AerorKus/FatChudRuns/README.md

# FatChudRuns
Threadmill for the crusty-ass white rat dog Tofu
