AerorKus/FatChudRuns/footprints/1825360_3/c-1825360-3-b-3d.stp

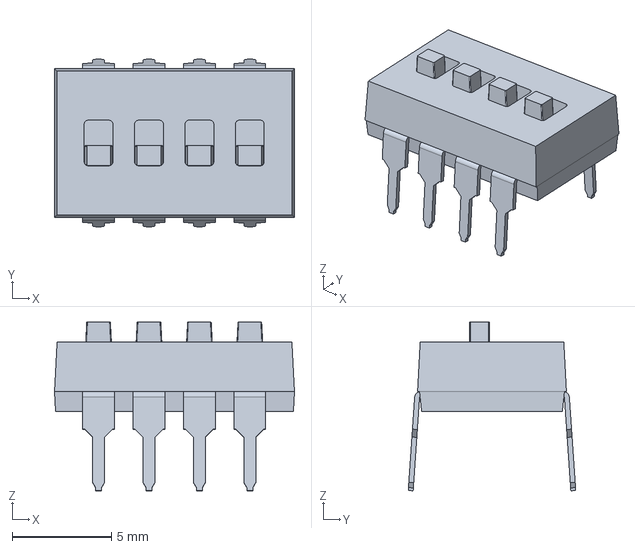
[picture p1: CAD file, 2026-03-14]
footprints/1825360_3/c-1825360-3-b-3d.stp
12.1 x 8.44 x 8.50 mm
