AerorKus/FatChudRuns/footprints/FTSH_107_01_L_DV_K_P/KiCADv6/CON14_2X7_DUK_FTSH_SAI.step

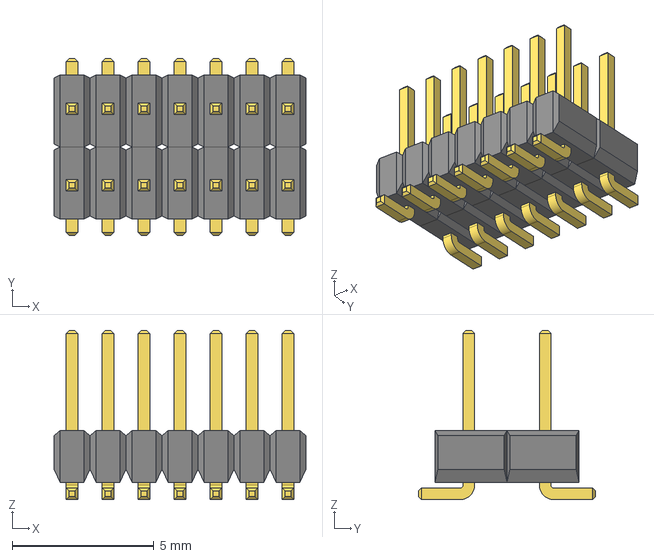
[picture p2: CAD file, 2026-03-02]
footprints/FTSH_107_01_L_DV_K_P/KiCADv6/CON14_2X7_DUK_FTSH_SAI.step
8.89 x 6.25 x 5.97 mm
