AerorKus/FatChudRuns/footprints/JXD6-0001NL/JXD6-0001NL.step

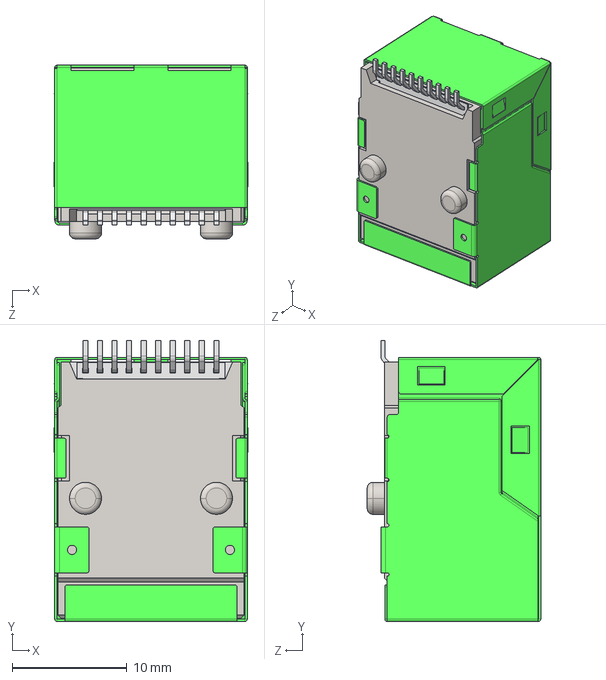
[picture p3: CAD file, 2026-04-10]
footprints/JXD6-0001NL/JXD6-0001NL.step
16.9 x 24.5 x 15.2 mm
