AerorKus/FatChudRuns/footprints/ST730M33R/SOT_30M33R_STM.step

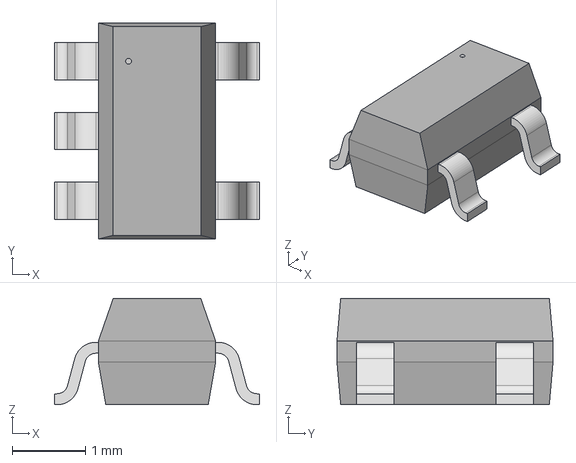
[picture p4: CAD file, 2026-03-04]
footprints/ST730M33R/SOT_30M33R_STM.step
2.79 x 2.95 x 1.45 mm
