AerorKus/FatChudRuns/footprints/TST_110_01_L_D/tst-110-01-l-d.stp

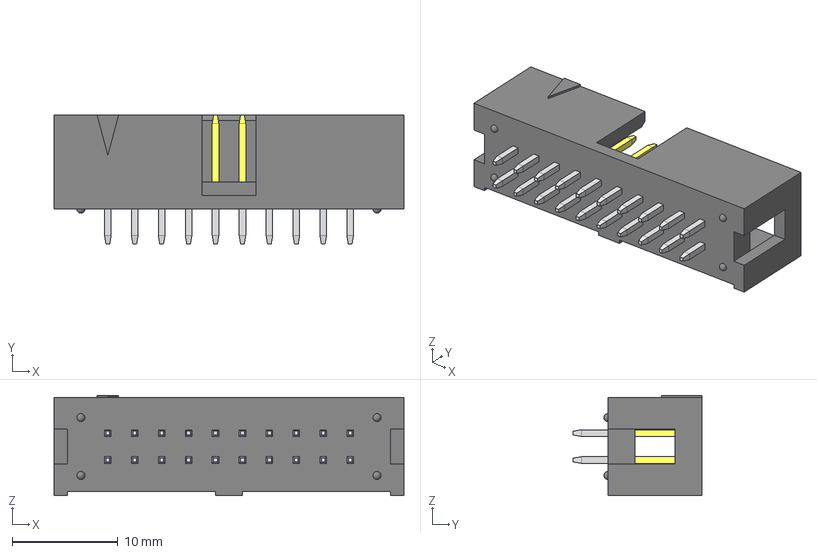
[picture p5: CAD file, 2026-03-01]
footprints/TST_110_01_L_D/tst-110-01-l-d.stp
33.0 x 12.2 x 9.47 mm
