AerorKus/FatChudRuns/ref/JXD6-0001NL.pdf

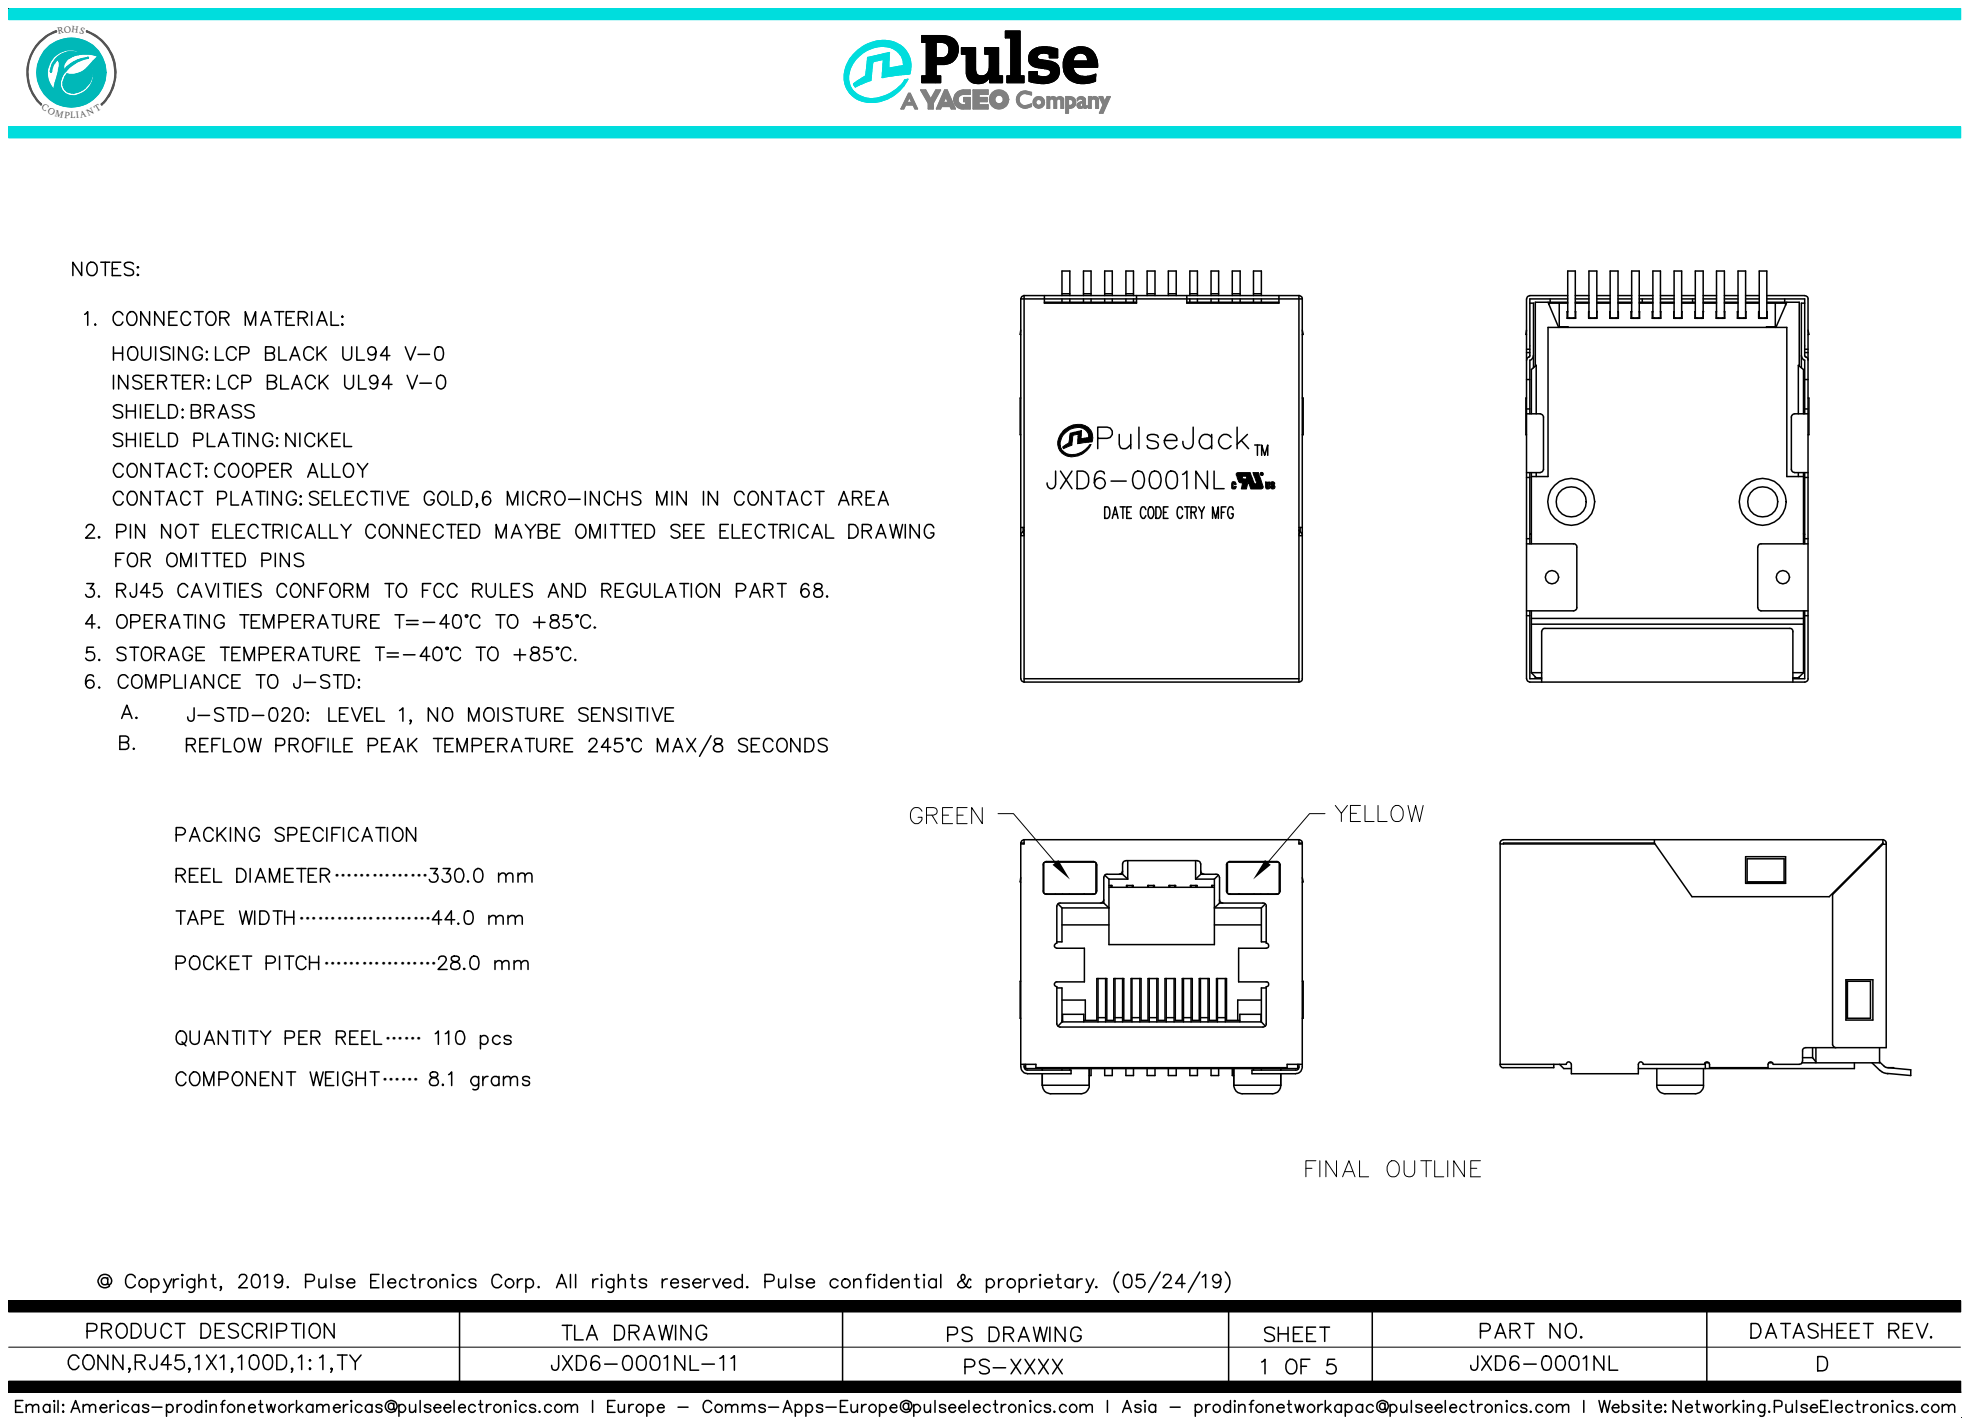
[picture p6: page 1]
ROHS; COM PLIA N T

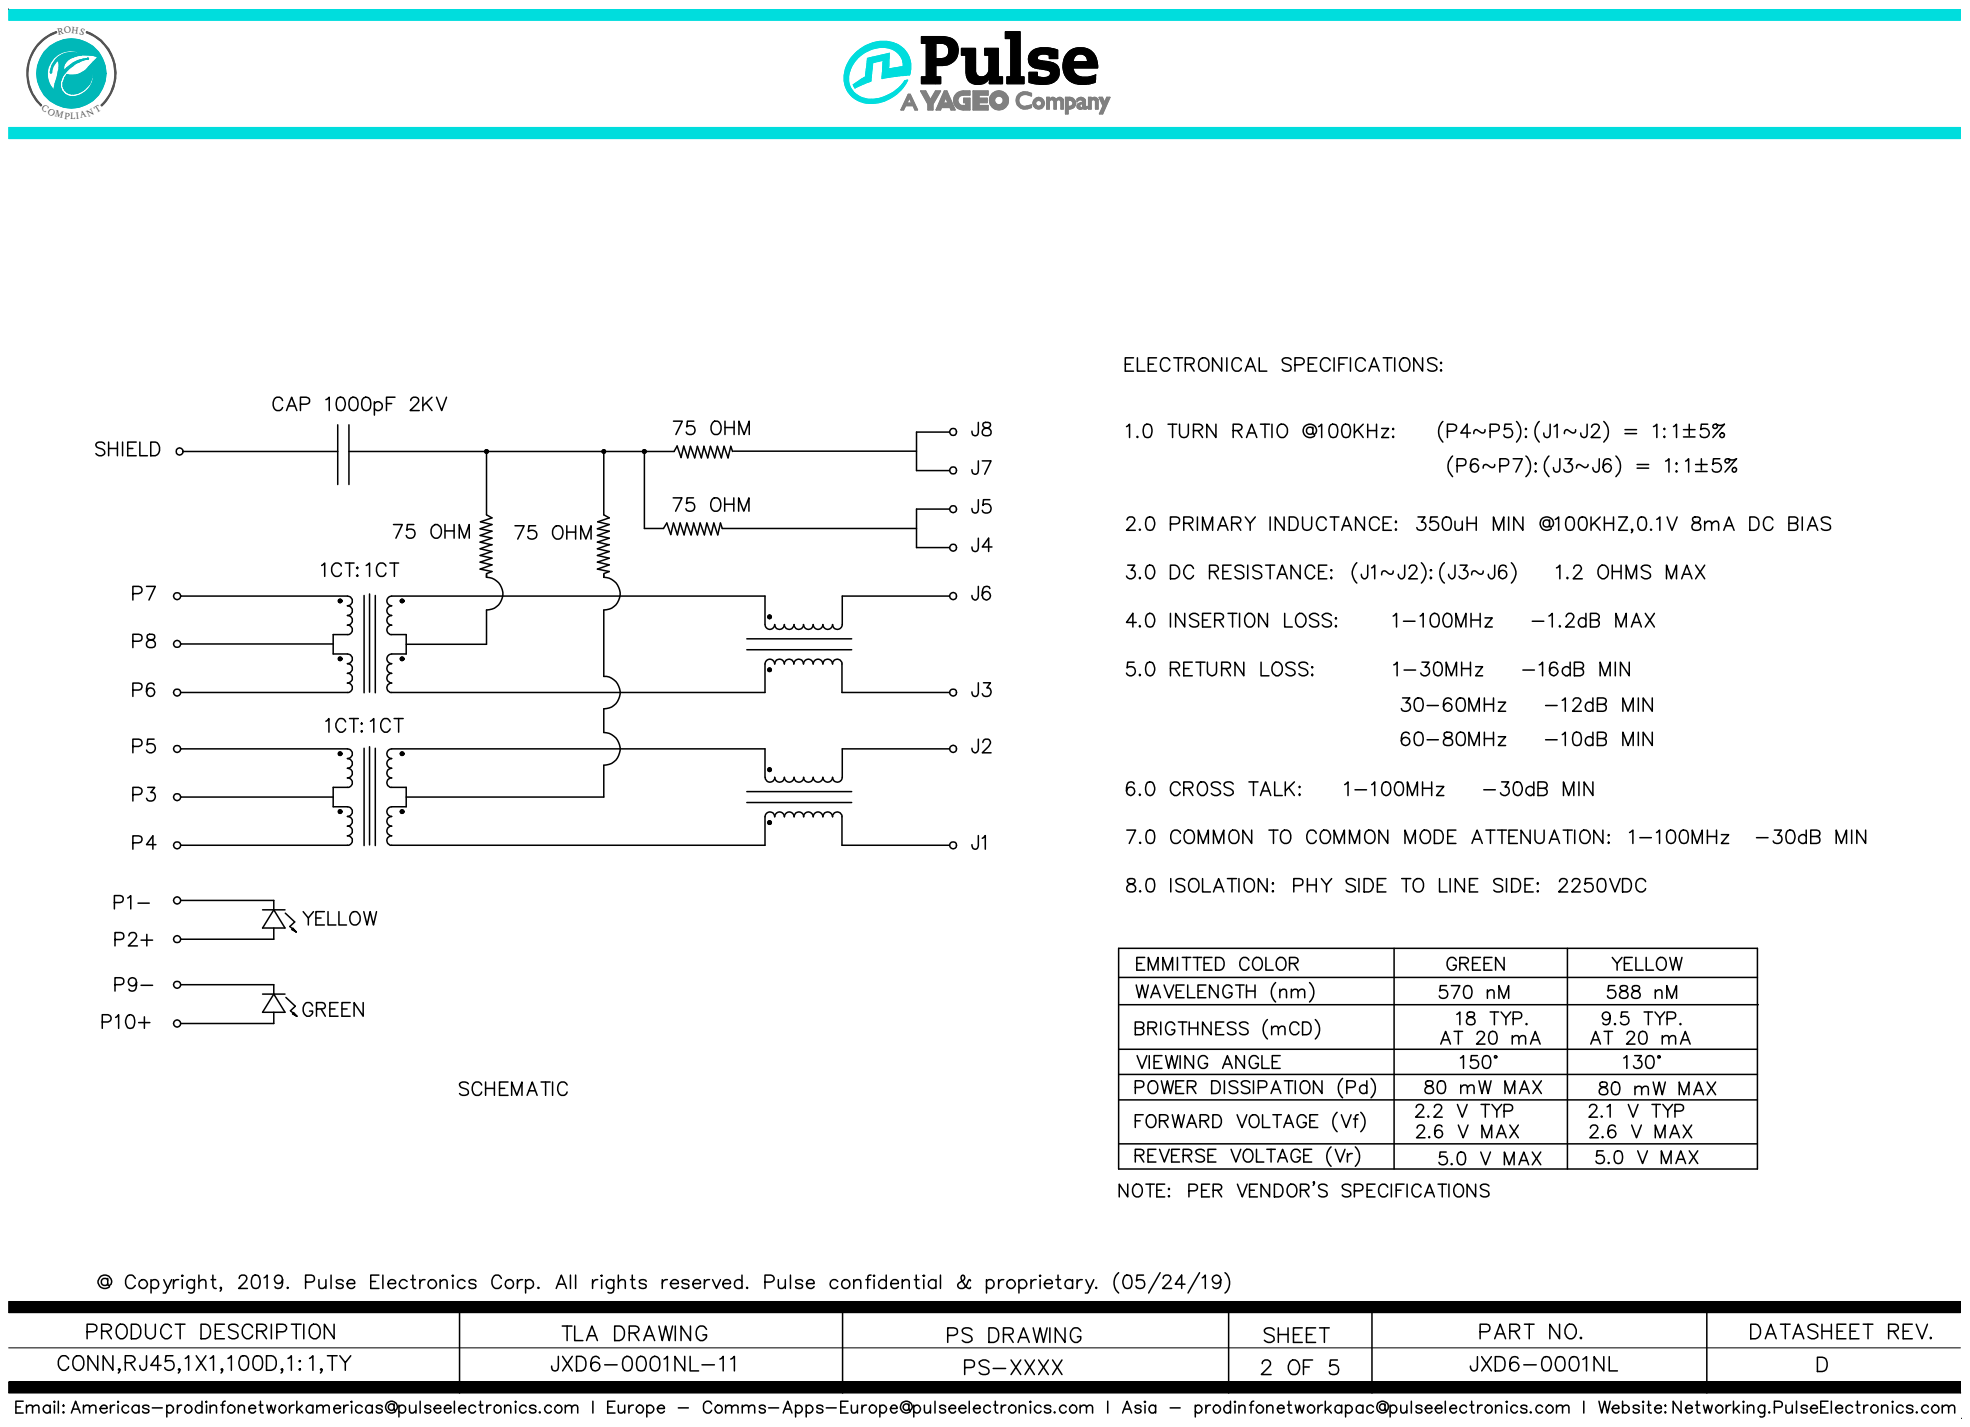
[picture p7: page 2]
COM PLIA N T

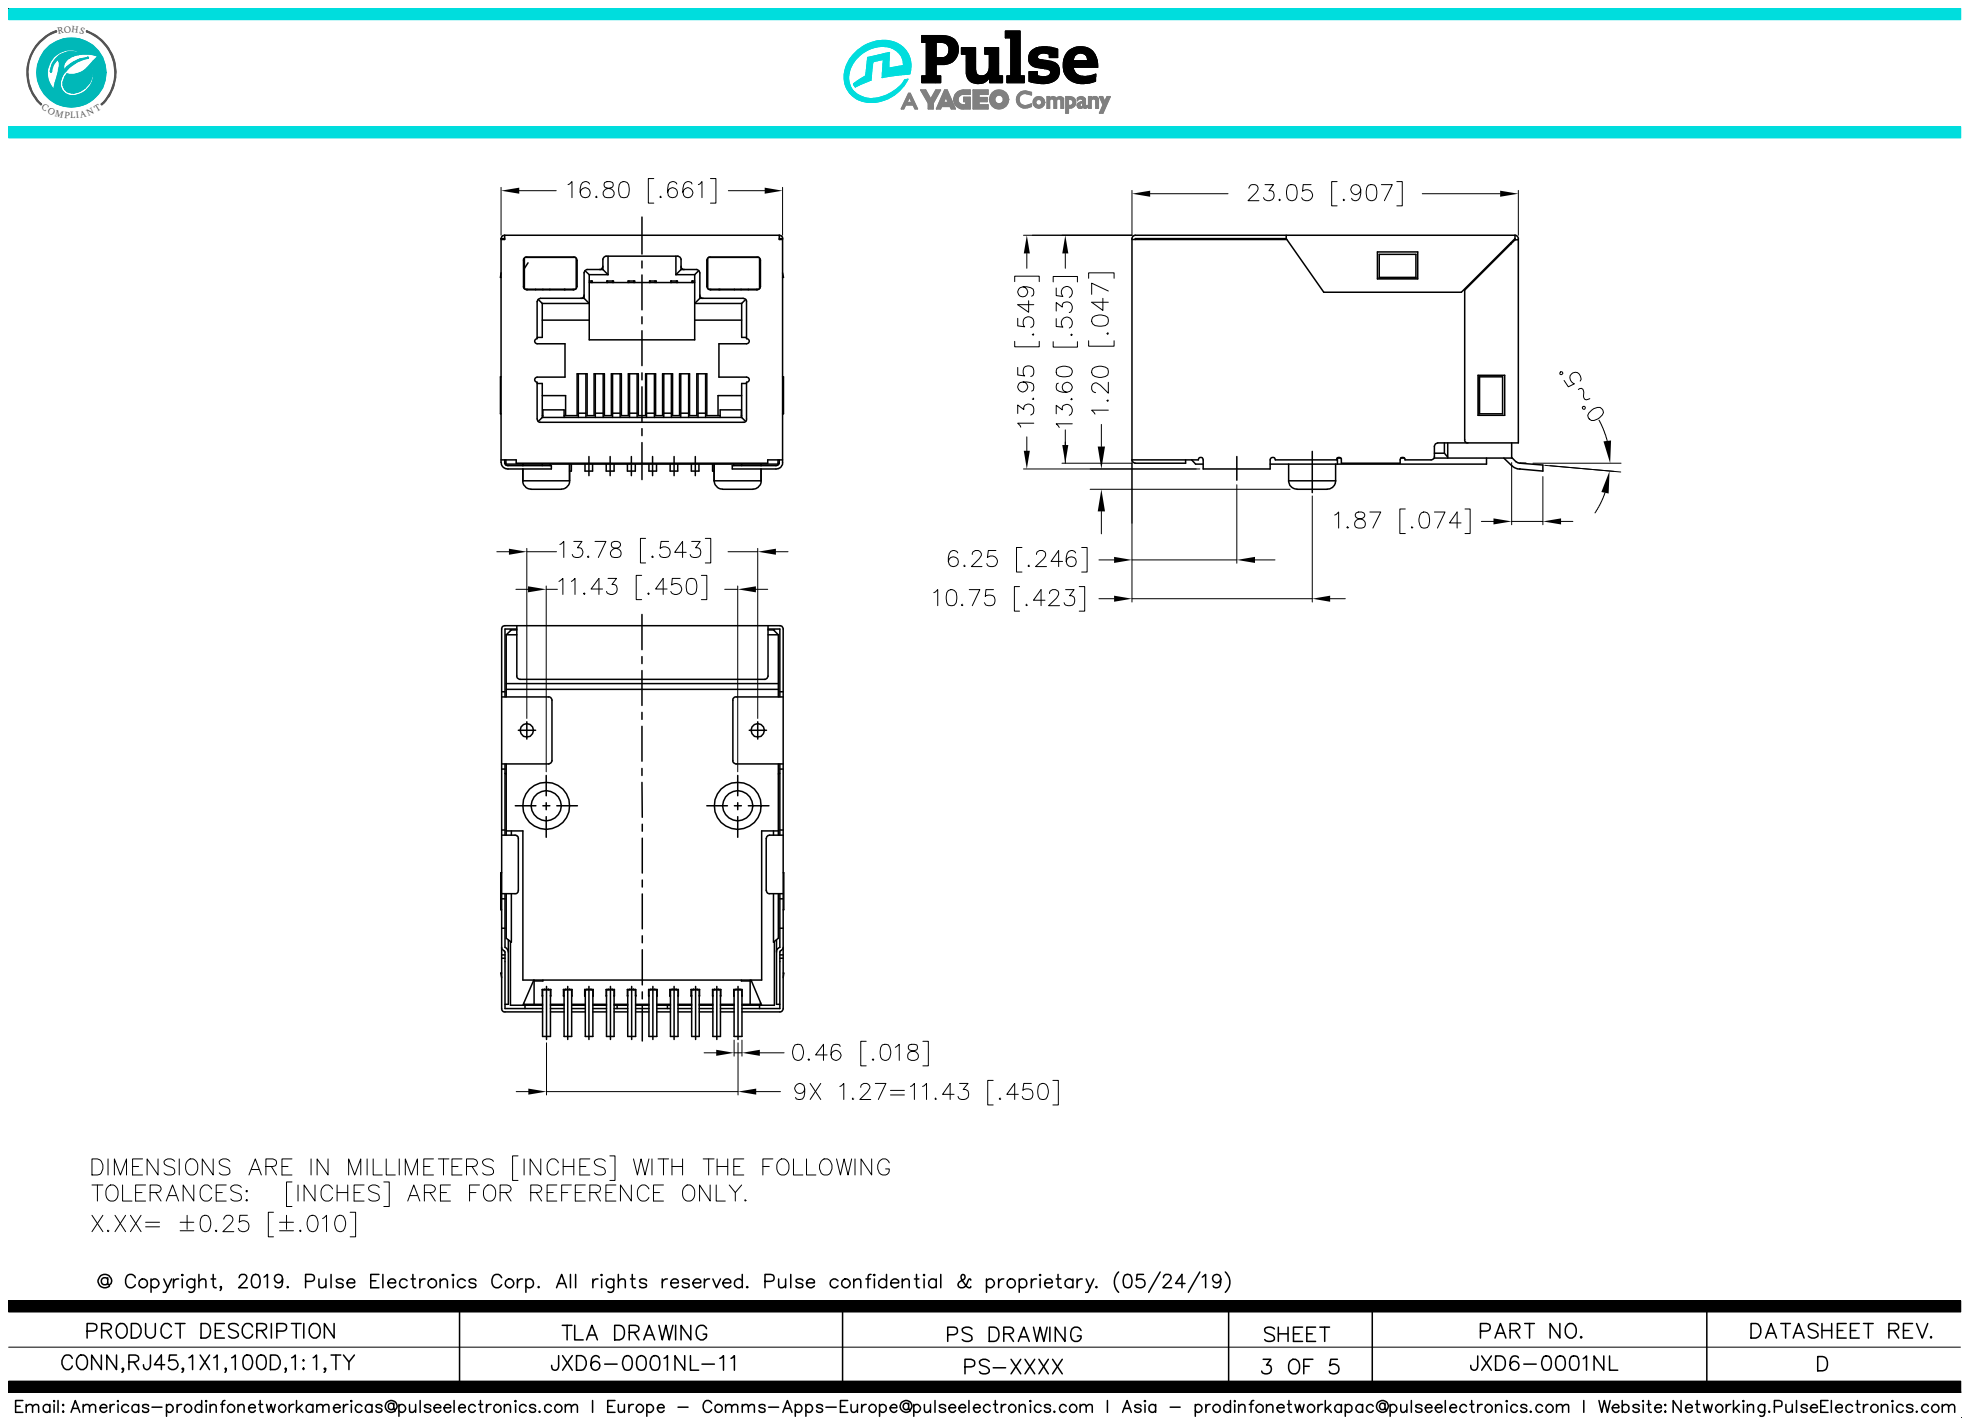
[picture p8: page 3]
COM PLIA N T

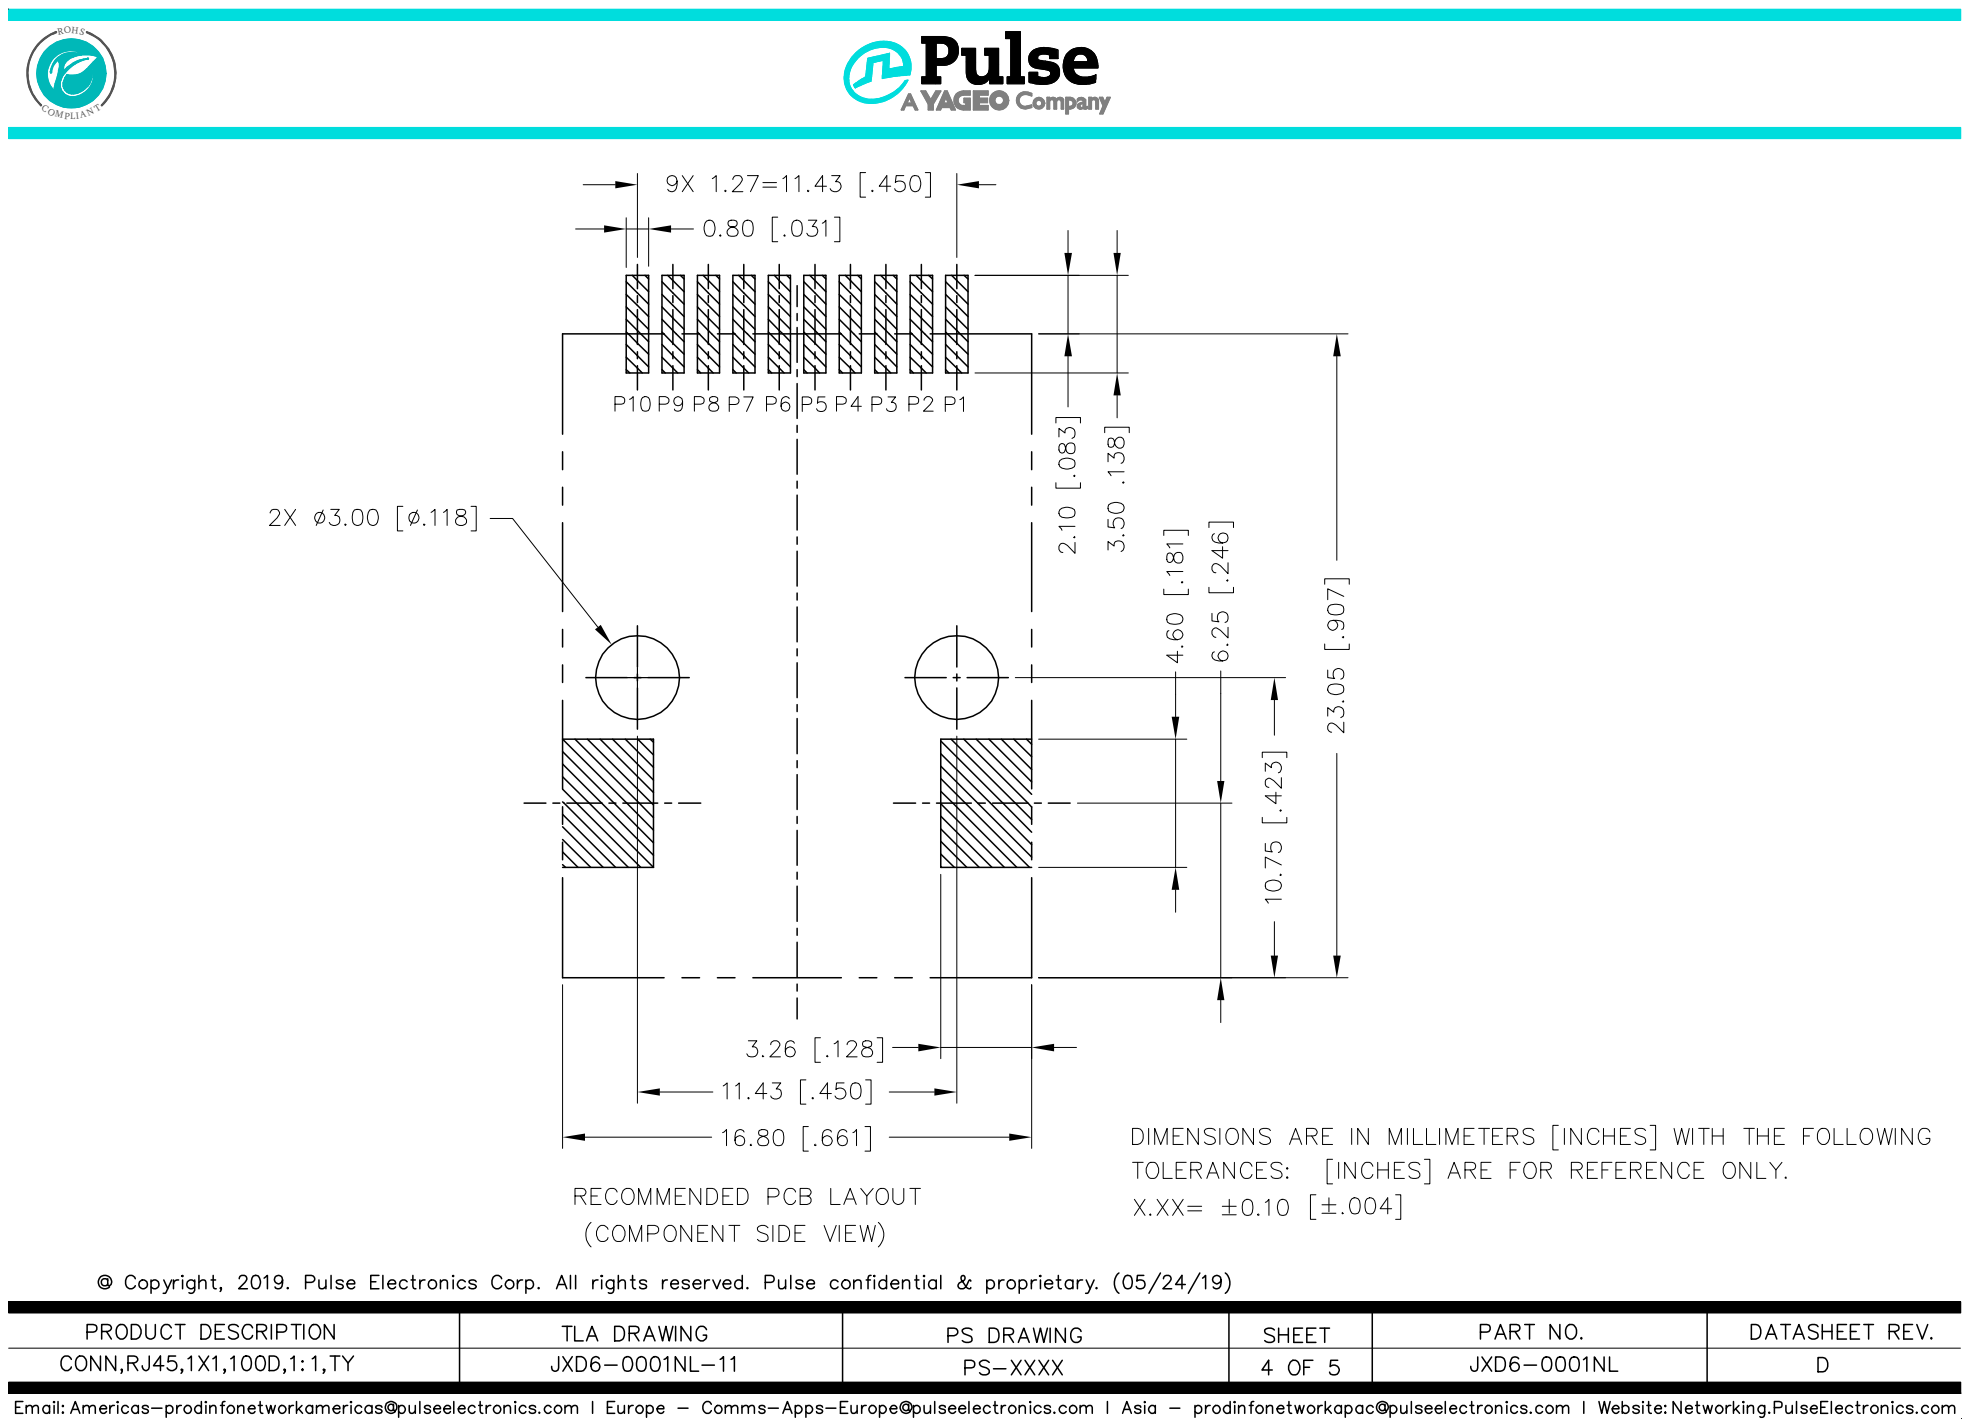
[picture p9: page 4]
COM PLIA N T

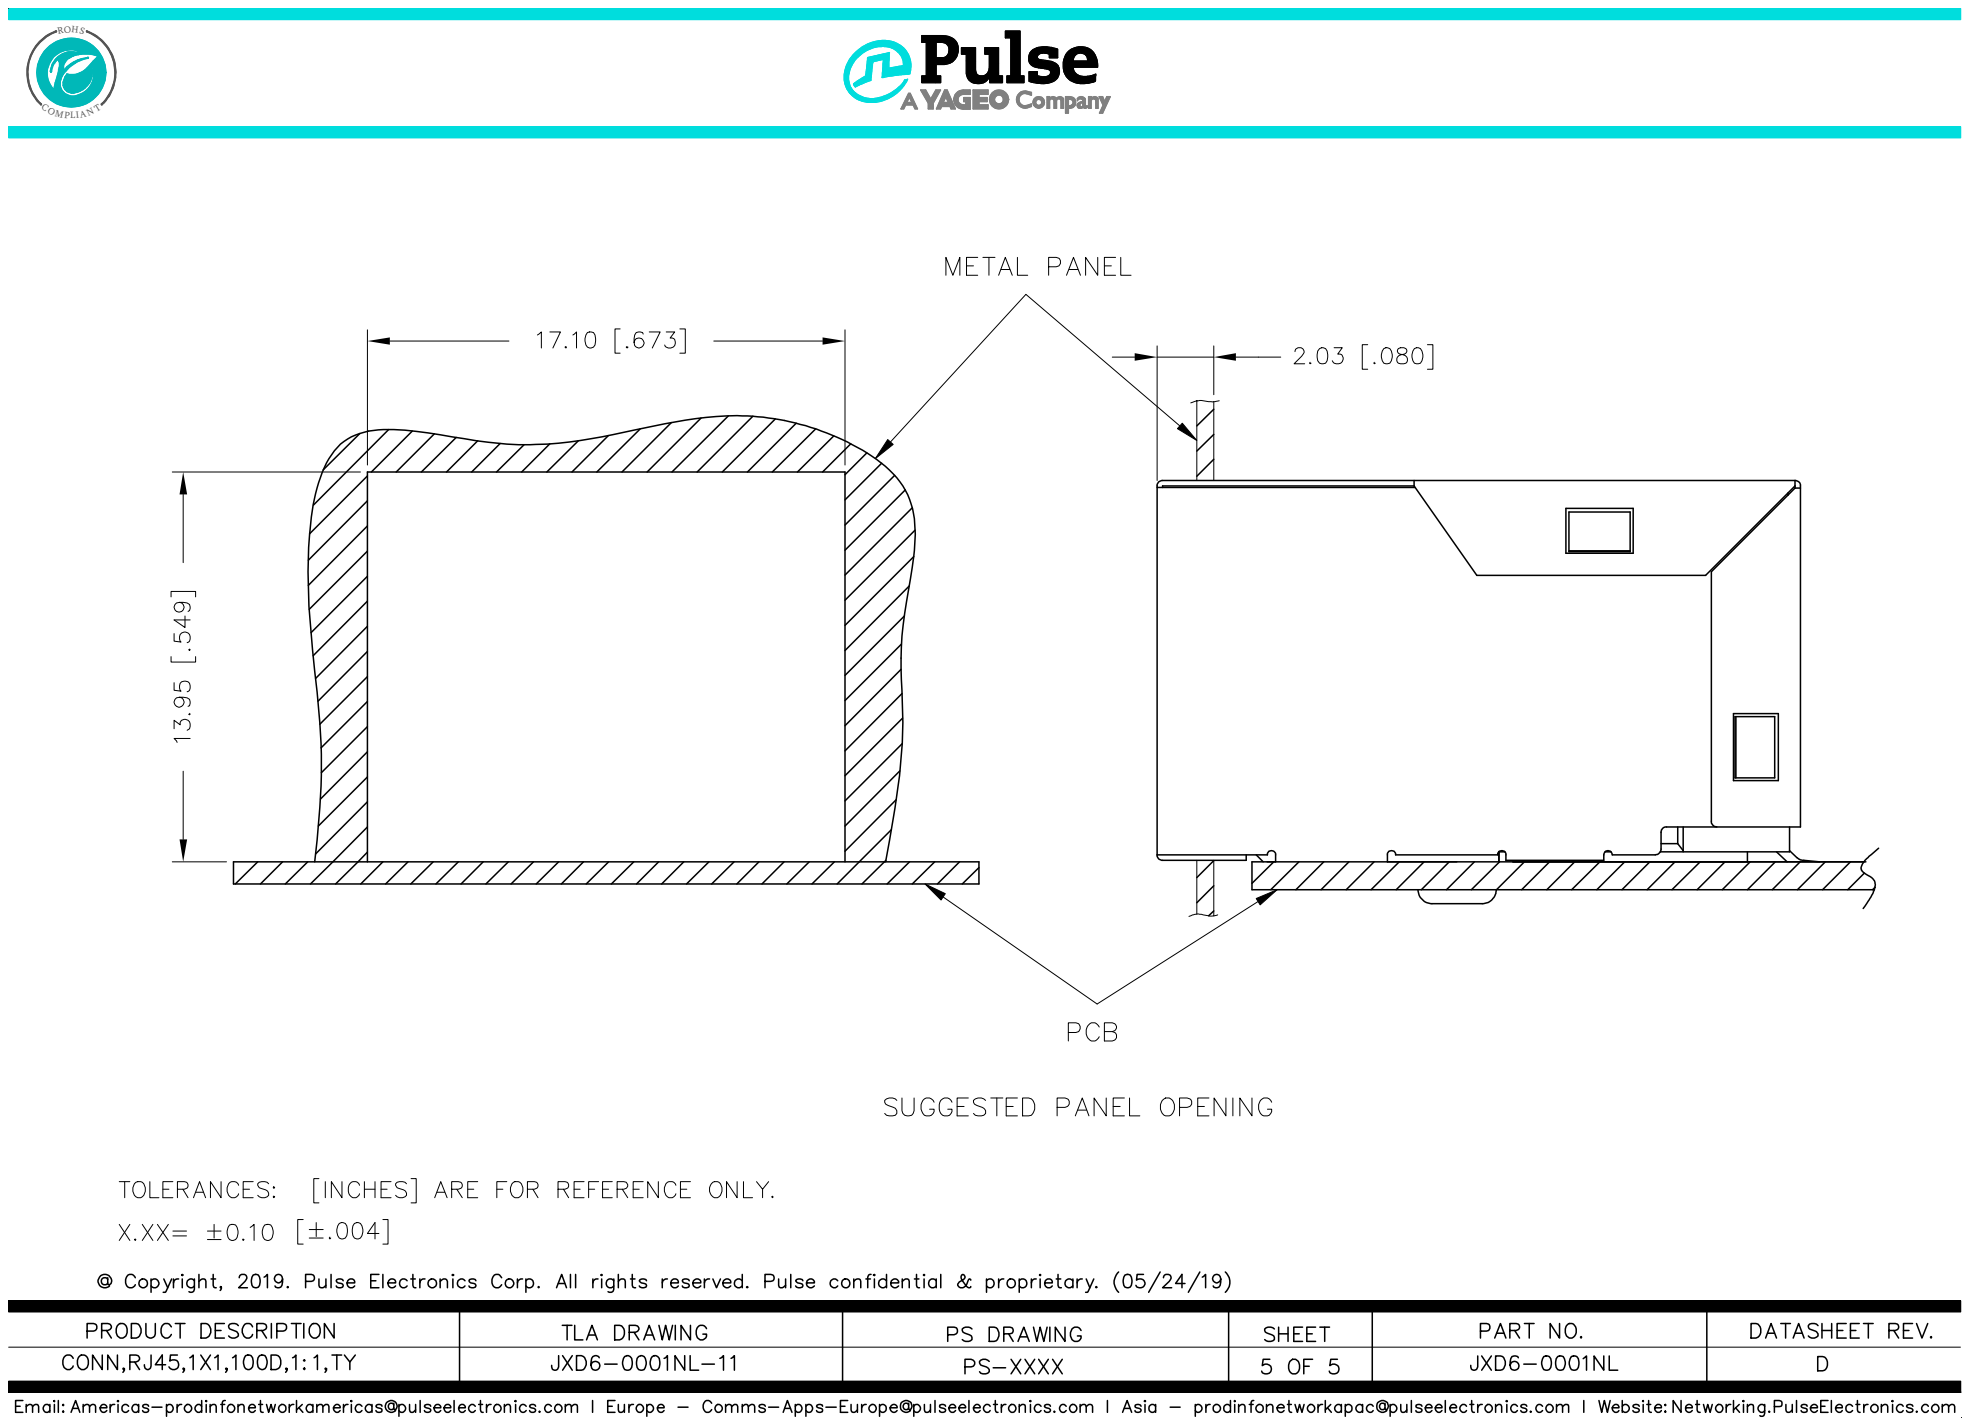
[picture p10: page 5]
COM PLIA N T
