AerorKus/FatChudRuns/FatChudRuns/FatChudRuns.kicad_pcb

## KiCad design FatChudRuns/FatChudRuns.kicad_pcb (2026-04-10)

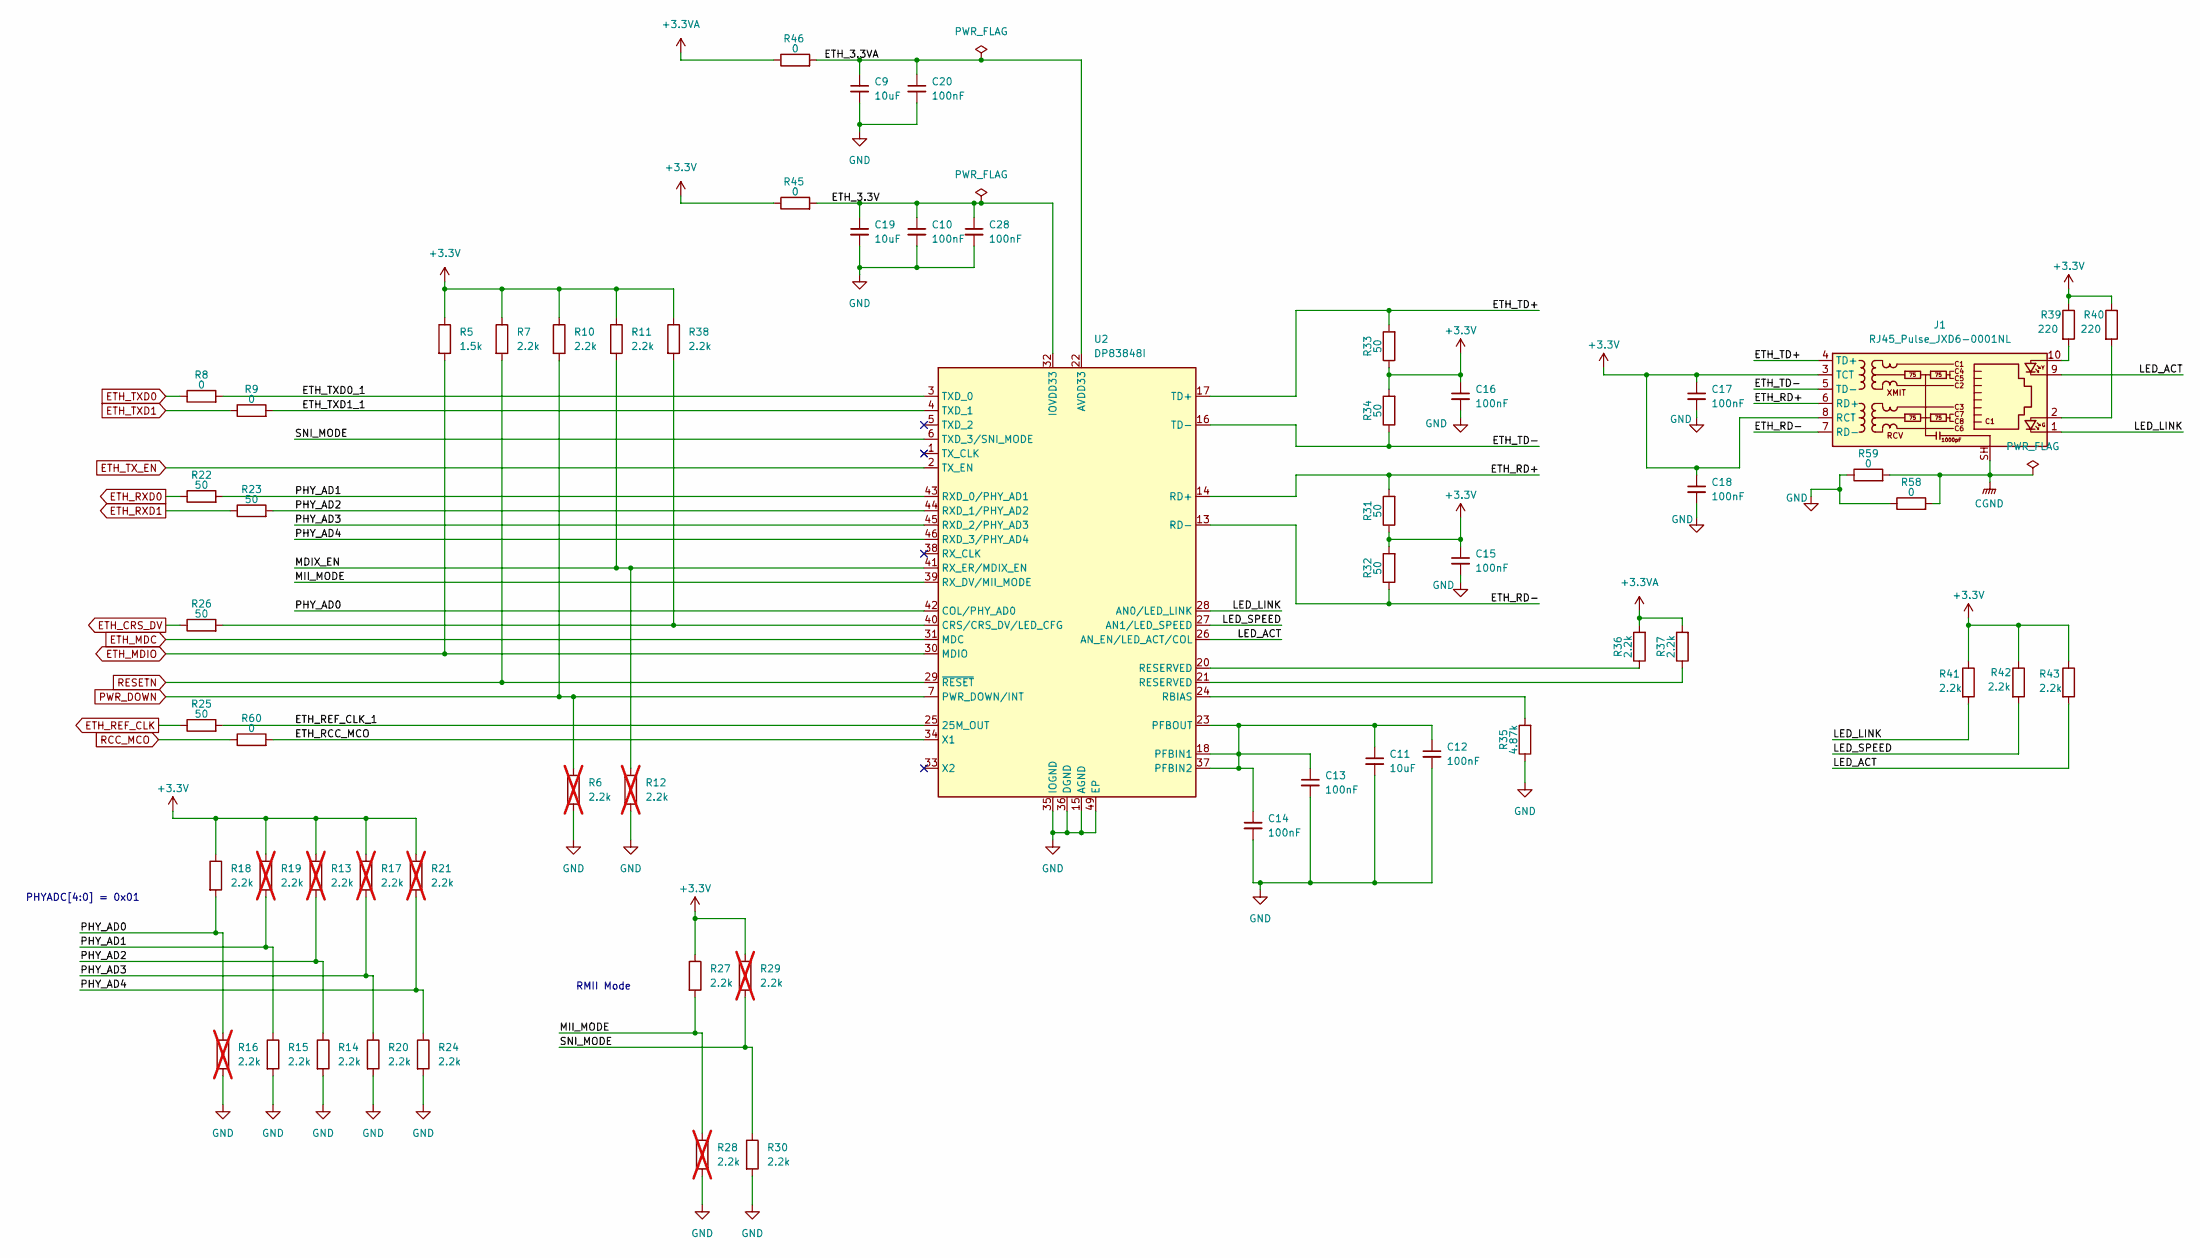
[picture p11: schematic ETH_PHY.kicad_sch]

Parts:
C9, C11, C19: 10uF; C_0805_2012Metric; JLCPCB Part # C2167271
C10, C12, C13, C14, C15, C16, C17, C18, C20, C28: 100nF; C_0603_1608Metric; JLCPCB Part # C2181816
J1: RJ45_Pulse_JXD6-0001NL; RJ45_Pulse_JXD6-0001NL_Horizontal; JLCPCB Part # C5359047
R5: 1.5k; R_0603_1608Metric; JLCPCB Part # C114668
R6, R12, R13, R16, R17, R19, R21, R28, R29: 2.2k; R_0603_1608Metric; not fitted
R7, R10, R11, R14, R15, R18, R20, R24, R27, R30, R36, R37, R38, R41, R42, R43: 2.2k; R_0603_1608Metric; JLCPCB Part # C113303
R8, R9, R45, R46, R58, R59, R60: 0; R_0603_1608Metric; JLCPCB Part # C95177
R22, R23, R25, R26, R31, R32, R33, R34: 50; R_0603_1608Metric; JLCPCB Part # C849792
R35: 4.87k; R_0603_1608Metric; JLCPCB Part # C137709
R39, R40: 220; R_0603_1608Metric; JLCPCB Part # C107696
U2: DP83848I; LQFP-48-1EP_7x7mm_P0.5mm_EP3.6x3.6mm_ThermalVias; JLCPCB Part # C12082

Connections:
+3.3V: C15.1, C16.1, C17.1, C18.1, J1.3 (TCT), J1.8 (RCT), R5.1, R7.1, R10.1, R11.1, R13.1, R17.1, R18.1, R19.1, R21.1, R27.1, R29.1, R31.1, R32.2, R33.1, R34.2, R38.1, R39.1, R40.1, R41.1, R42.1, R43.1, R45.1; also elsewhere on the board
+3.3VA: R36.2, R37.2, R46.1; also elsewhere on the board
/ETH_PHY/ETH_3.3V: C10.1, C19.1, C28.1, R45.2, U2.32 (IOVDD33), U2.48 (IOVDD33)
/ETH_PHY/ETH_3.3VA: C9.1, C20.1, R46.2, U2.22 (AVDD33)
/ETH_PHY/ETH_RCC_MCO: R60.2, U2.34 (X1)
/ETH_PHY/ETH_RD+: J1.6 (RD+), R31.2, U2.14 (RD+)
/ETH_PHY/ETH_RD-: J1.7 (RD-), R32.1, U2.13 (RD-)
/ETH_PHY/ETH_REF_CLK_1: R25.2, U2.25 (25M_OUT)
/ETH_PHY/ETH_TD+: J1.4 (TD+), R33.2, U2.17 (TD+)
/ETH_PHY/ETH_TD-: J1.5 (TD-), R34.1, U2.16 (TD-)
/ETH_PHY/ETH_TXD0_1: R8.2, U2.3 (TXD_0)
/ETH_PHY/ETH_TXD1_1: R9.2, U2.4 (TXD_1)
/ETH_PHY/LED_ACT: J1.9, R43.2, U2.26 (AN_EN/LED_ACT/COL)
/ETH_PHY/LED_LINK: J1.1, R41.2, U2.28 (AN0/LED_LINK)
/ETH_PHY/LED_SPEED: R42.2, U2.27 (AN1/LED_SPEED)
/ETH_PHY/MDIX_EN: R11.2, R12.1, U2.41 (RX_ER/MDIX_EN)
/ETH_PHY/MII_MODE: R27.2, R28.1, U2.39 (RX_DV/MII_MODE)
/ETH_PHY/PHY_AD0: R16.1, R18.2, U2.42 (COL/PHY_AD0)
/ETH_PHY/PHY_AD1: R15.1, R19.2, R22.2, U2.43 (RXD_0/PHY_AD1)
/ETH_PHY/PHY_AD2: R13.2, R14.1, R23.2, U2.44 (RXD_1/PHY_AD2)
/ETH_PHY/PHY_AD3: R17.2, R20.1, U2.45 (RXD_2/PHY_AD3)
/ETH_PHY/PHY_AD4: R21.2, R24.1, U2.46 (RXD_3/PHY_AD4)
/ETH_PHY/SNI_MODE: R29.2, R30.1, U2.6 (TXD_3/SNI_MODE)
CGND: J1.SH, R58.2, R59.2
ETH_CRS_DV: R26.1; also elsewhere on the board
ETH_MDC: U2.31 (MDC); also elsewhere on the board
ETH_MDIO: R5.2, U2.30 (MDIO); also elsewhere on the board
ETH_REF_CLK: R25.1; also elsewhere on the board
ETH_RXD0: R22.1; also elsewhere on the board
ETH_RXD1: R23.1; also elsewhere on the board
ETH_TXD0: R8.1; also elsewhere on the board
ETH_TXD1: R9.1; also elsewhere on the board
ETH_TX_EN: U2.2 (TX_EN); also elsewhere on the board
GND: C9.2, C10.2, C11.2, C12.2, C13.2, C14.2, C15.2, C16.2, C17.2, C18.2, C19.2, C20.2, C28.2, R6.2, R12.2, R14.2, R15.2, R16.2, R20.2, R24.2, R28.2, R30.2, R35.1, R58.1, R59.1, U2.15 (AGND), U2.19 (AGND), U2.35 (IOGND), U2.36 (DGND), U2.47 (IOGND), U2.49 (EP); also elsewhere on the board
unnamed: J1.2, R40.2
unnamed: J1.10, R39.2
unnamed: R36.1, U2.20 (RESERVED)
unnamed: R37.1, U2.21 (RESERVED)
unnamed: R26.2, R38.2, U2.40 (CRS/CRS_DV/LED_CFG)
unnamed: C11.1, C12.1, C13.1, C14.1, U2.18 (PFBIN1), U2.23 (PFBOUT), U2.37 (PFBIN2)
unnamed: R35.2, U2.24 (RBIAS)
PWR_DOWN: R6.1, R10.2, U2.7 (PWR_DOWN/INT)
RCC_MCO: R60.1; also elsewhere on the board
RESETN: R7.2, U2.29 (~RESET)

Notes on the sheet:
RMII Mode
PHYADC[4:0] = 0x01

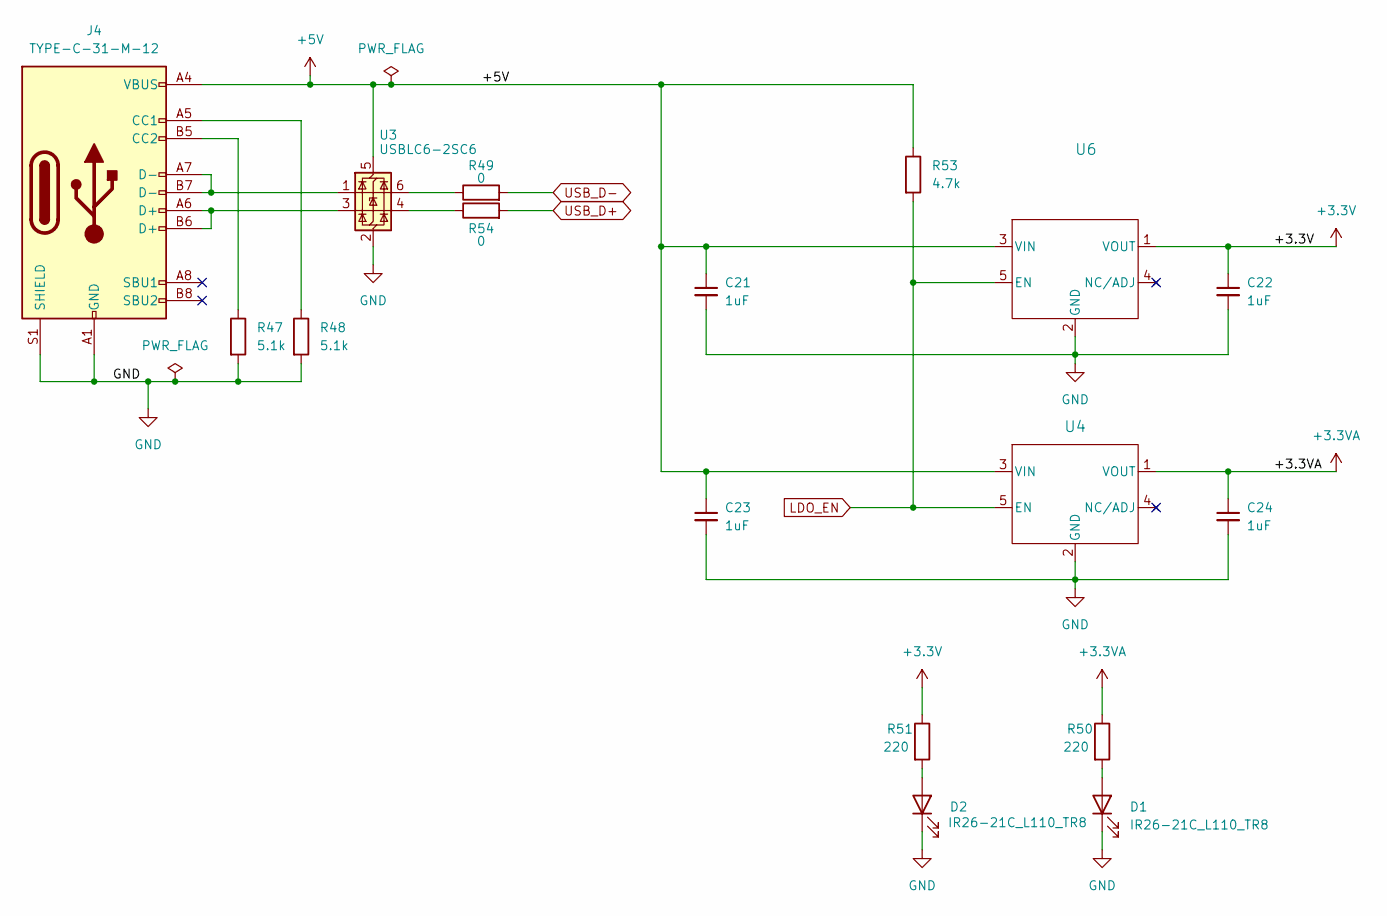
[picture p12: schematic POWER.kicad_sch]

Parts:
C21, C22, C23, C24: 1uF; C_0603_1608Metric; JLCPCB Part # C561804
D1, D2: IR26-21C_L110_TR8; LED_1206_3216Metric; JLCPCB Part # C73929
J4: TYPE-C-31-M-12; USB_C_Receptacle_GCT_USB4105-xx-A_16P_TopMnt_Horizontal; JLCPCB Part # C165948
R47, R48: 5.1k; R_0603_1608Metric; JLCPCB Part # C14677
R49, R54: 0; R_0603_1608Metric; JLCPCB Part # C95177
R50, R51: 220; R_0603_1608Metric; JLCPCB Part # C107696
R53: 4.7k; R_0603_1608Metric; JLCPCB Part # C99782
U3: USBLC6-2SC6; SOT-23-6; JLCPCB Part # C7519
U4, U6: ST730M33R; SOT_30M33R_STM; JLCPCB Part # C2846046

Connections:
+3.3V: C22.1, R51.1, U6.1 (VOUT); also elsewhere on the board
+3.3VA: C24.1, R50.1, U4.1 (VOUT); also elsewhere on the board
+5V: C21.1, C23.1, J4.A4 (VBUS), J4.A9 (VBUS), J4.B4 (VBUS), J4.B9 (VBUS), R53.1, U3.5 (VBUS), U4.3 (VIN), U6.3 (VIN)
GND: C21.2, C22.2, C23.2, C24.2, D1.1 (K), D2.1 (K), J4.A1 (GND), J4.A12 (GND), J4.B1 (GND), J4.B12 (GND), J4.S1 (SHIELD), R47.2, R48.2, U3.2 (GND), U4.2 (GND), U6.2 (GND); also elsewhere on the board
LDO_EN: R53.2, U4.5 (EN), U6.5 (EN); also elsewhere on the board
unnamed: D1.2 (A), R50.2
unnamed: D2.2 (A), R51.2
unnamed: J4.A5 (CC1), R48.1
unnamed: J4.B5 (CC2), R47.1
unnamed: J4.A6 (D+), J4.B6 (D+), U3.3 (I/O2)
unnamed: J4.A7 (D-), J4.B7 (D-), U3.1 (I/O1)
unnamed: R49.1, U3.6 (I/O1)
unnamed: R54.1, U3.4 (I/O2)
USB_D+: R54.2; also elsewhere on the board
USB_D-: R49.2; also elsewhere on the board

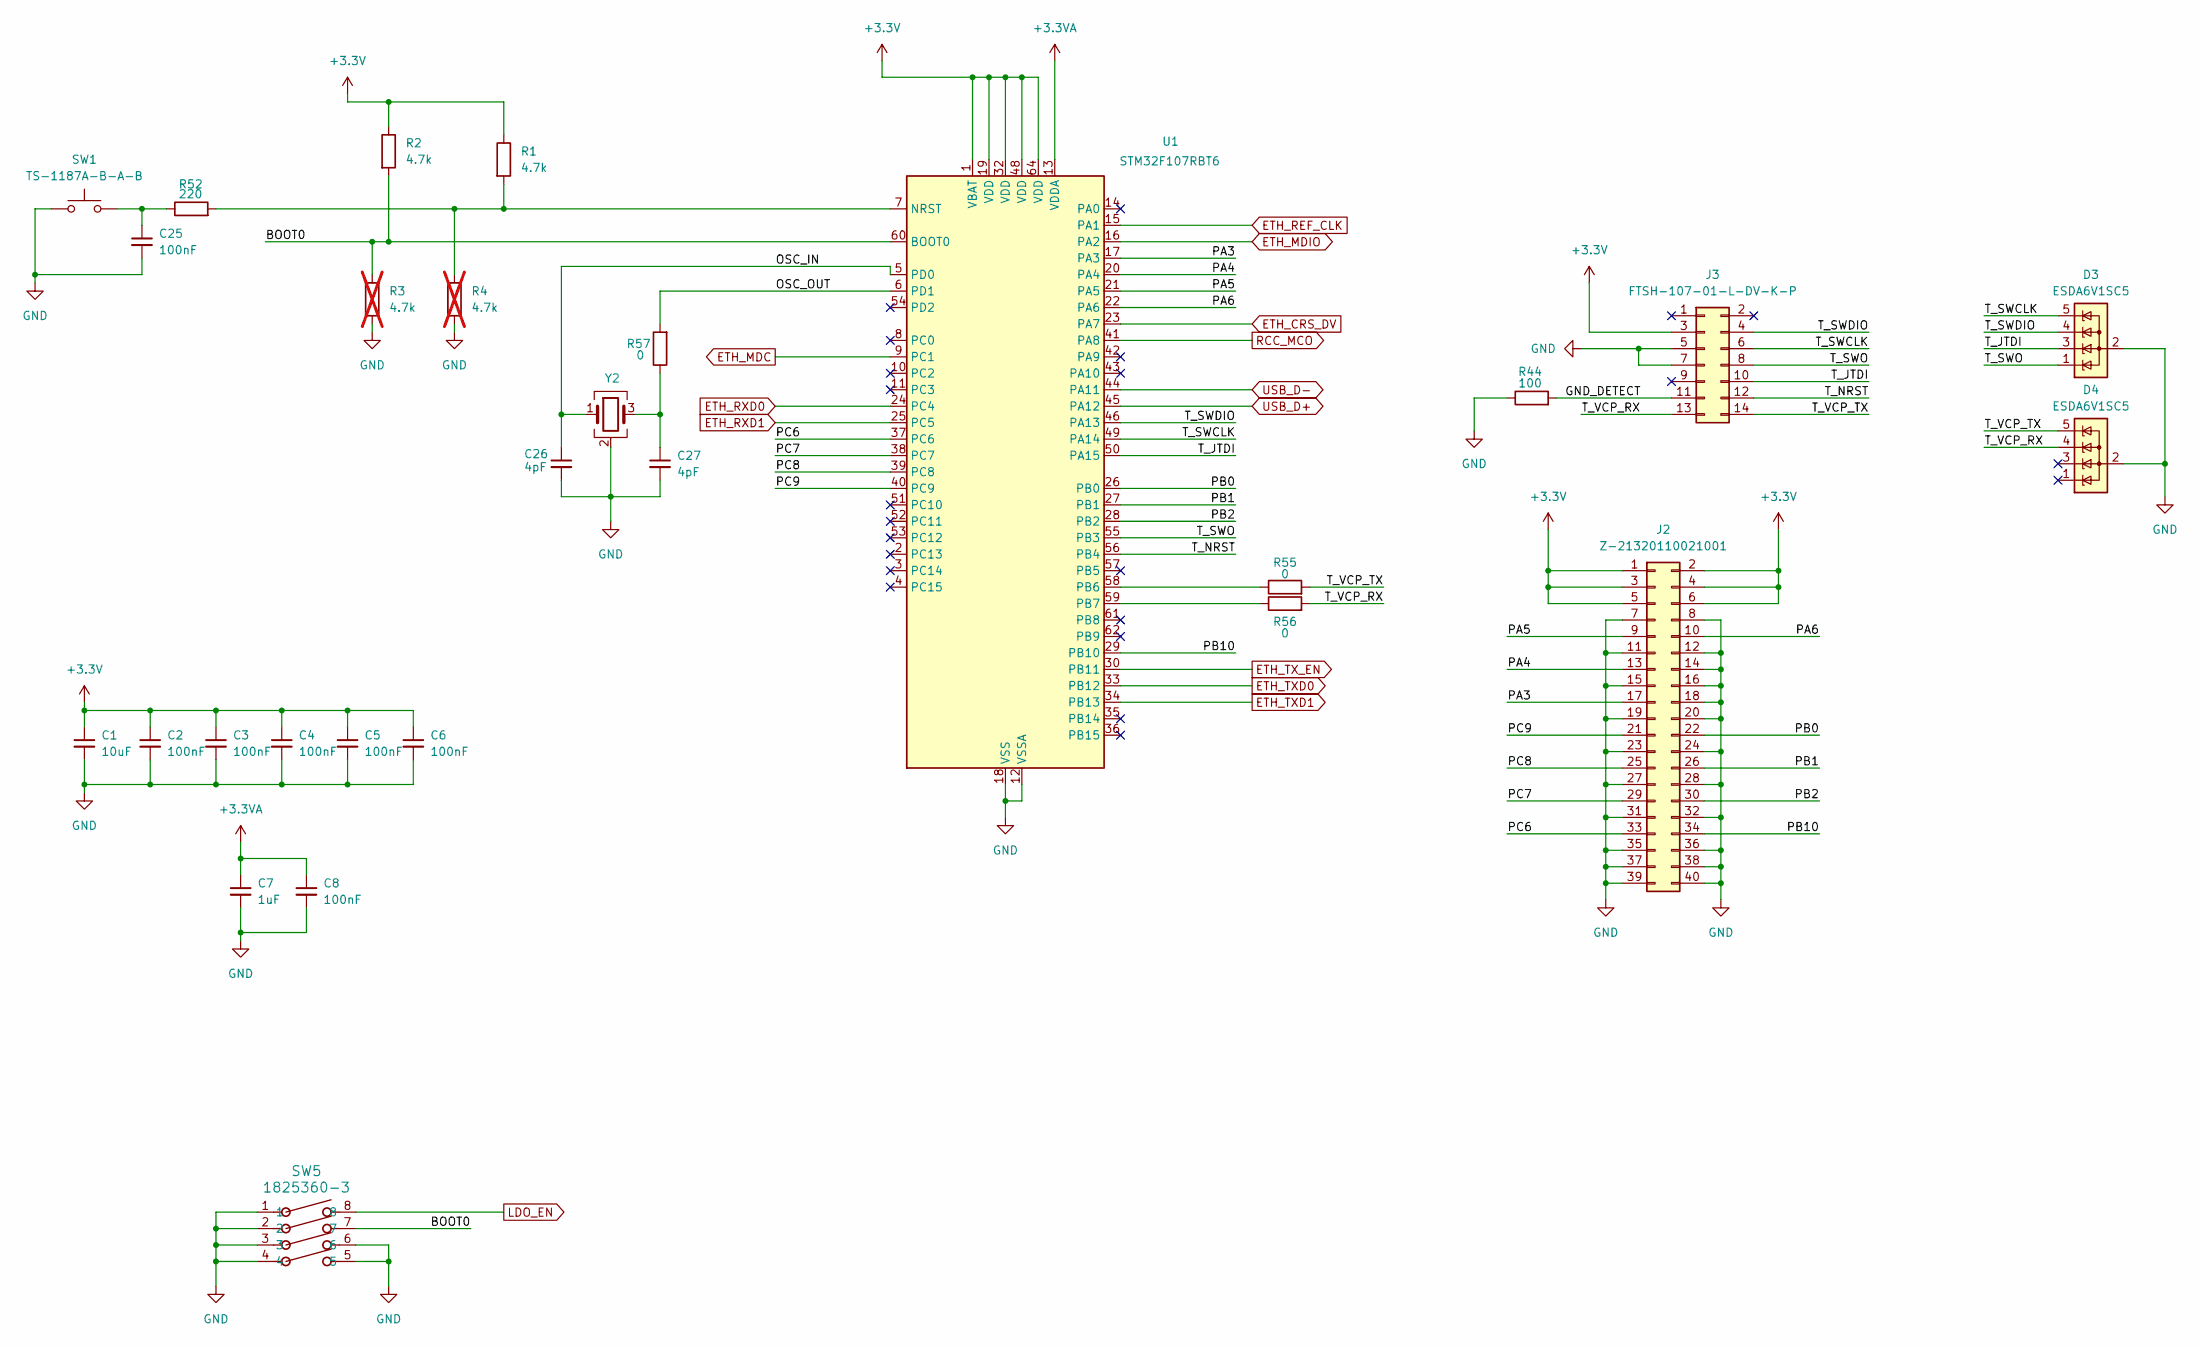
[picture p13: schematic MCU.kicad_sch]

Parts:
C1: 10uF; C_0805_2012Metric; JLCPCB Part # C2167271
C2, C3, C4, C5, C6, C8, C25: 100nF; C_0603_1608Metric; JLCPCB Part # C2181816
C7: 1uF; C_0603_1608Metric; JLCPCB Part # C561804
C26, C27: 4pF; C_0603_1608Metric; JLCPCB Part # C309461
D3, D4: ESDA6V1SC5; SOT-23-5; JLCPCB Part # C2935146
J2: Z-21320110021001; PinSocket_2x20_P2.54mm_Vertical; JLCPCB Part # C193453
J3: FTSH-107-01-L-DV-K-P; CON14_2X7_DUK_FTSH_SAI; JLCPCB Part # C5345538
R1, R2: 4.7k; R_0603_1608Metric; JLCPCB Part # C99782
R3, R4: 4.7k; R_0603_1608Metric; not fitted
R44: 100; R_0603_1608Metric; JLCPCB Part # C105588
R52: 220; R_0603_1608Metric; JLCPCB Part # C107696
R55, R56, R57: 0; R_0603_1608Metric; JLCPCB Part # C95177
SW1: TS-1187A-B-A-B; SW_SPST_TL3342; JLCPCB Part # C318884
SW5: 1825360-3; SWDIP8_300X185P100; JLCPCB Part # C574798
U1: STM32F107RBT6; LQFP-64_10x10mm_P0.5mm; JLCPCB Part # C16918
Y2: ABM8G-25.000MHZ-B4Y-T; Crystal_SMD_Abracon_ABM8AIG-4Pin_3.2x2.5mm; JLCPCB Part # C596913

Connections:
+3.3V: C1.1, C2.1, C3.1, C4.1, C5.1, C6.1, J2.1, J2.2, J2.3, J2.4, J2.5, J2.6, J3.3, R1.1, R2.1, U1.1 (VBAT), U1.19 (VDD), U1.32 (VDD), U1.48 (VDD), U1.64 (VDD); also elsewhere on the board
+3.3VA: C7.1, C8.1, U1.13 (VDDA); also elsewhere on the board
/MCU/BOOT0: R2.2, R3.1, SW5.7, U1.60 (BOOT0)
/MCU/GND_DETECT: J3.11, R44.2
/MCU/OSC_IN: C26.1, U1.5 (PD0), Y2.1
/MCU/OSC_OUT: R57.2, U1.6 (PD1)
/MCU/PA3: J2.17, U1.17 (PA3)
/MCU/PA4: J2.13, U1.20 (PA4)
/MCU/PA5: J2.9, U1.21 (PA5)
/MCU/PA6: J2.10, U1.22 (PA6)
/MCU/PB0: J2.22, U1.26 (PB0)
/MCU/PB1: J2.26, U1.27 (PB1)
/MCU/PB2: J2.30, U1.28 (PB2)
/MCU/PB10: J2.34, U1.29 (PB10)
/MCU/PC6: J2.33, U1.37 (PC6)
/MCU/PC7: J2.29, U1.38 (PC7)
/MCU/PC8: J2.25, U1.39 (PC8)
/MCU/PC9: J2.21, U1.40 (PC9)
/MCU/T_JTDI: D3.3 (K), J3.10, U1.50 (PA15)
/MCU/T_NRST: J3.12, U1.56 (PB4)
/MCU/T_SWCLK: D3.5 (K), J3.6, U1.49 (PA14)
/MCU/T_SWDIO: D3.4 (K), J3.4, U1.46 (PA13)
/MCU/T_SWO: D3.1 (K), J3.8, U1.55 (PB3)
/MCU/T_VCP_RX: D4.4 (K), J3.13, R56.2
/MCU/T_VCP_TX: D4.5 (K), J3.14, R55.2
ETH_CRS_DV: U1.23 (PA7); also elsewhere on the board
ETH_MDC: U1.9 (PC1); also elsewhere on the board
ETH_MDIO: U1.16 (PA2); also elsewhere on the board
ETH_REF_CLK: U1.15 (PA1); also elsewhere on the board
ETH_RXD0: U1.24 (PC4); also elsewhere on the board
ETH_RXD1: U1.25 (PC5); also elsewhere on the board
ETH_TXD0: U1.33 (PB12); also elsewhere on the board
ETH_TXD1: U1.34 (PB13); also elsewhere on the board
ETH_TX_EN: U1.30 (PB11); also elsewhere on the board
GND: C1.2, C2.2, C3.2, C4.2, C5.2, C6.2, C7.2, C8.2, C25.2, C26.2, C27.2, D3.2 (A), D4.2 (A), J2.7, J2.8, J2.11, J2.12, J2.14, J2.15, J2.16, J2.18, J2.19, J2.20, J2.23, J2.24, J2.27, J2.28, J2.31, J2.32, J2.35, J2.36, J2.37, J2.38, J2.39, J2.40, J3.5, J3.7, R3.2, R4.2, R44.1, SW1.1, SW5.1, SW5.2, SW5.3, SW5.4, SW5.5, SW5.6, U1.12 (VSSA), U1.18 (VSS), U1.31 (VSS), U1.47 (VSS), U1.63 (VSS), Y2.2 (G), Y2.4 (G); also elsewhere on the board
LDO_EN: SW5.8; also elsewhere on the board
unnamed: C25.1, R52.1, SW1.2
unnamed: C27.1, R57.1, Y2.3
unnamed: R1.2, R4.1, R52.2, U1.7 (NRST)
unnamed: R55.1, U1.58 (PB6)
unnamed: R56.1, U1.59 (PB7)
RCC_MCO: U1.41 (PA8); also elsewhere on the board
USB_D+: U1.45 (PA12); also elsewhere on the board
USB_D-: U1.44 (PA11); also elsewhere on the board

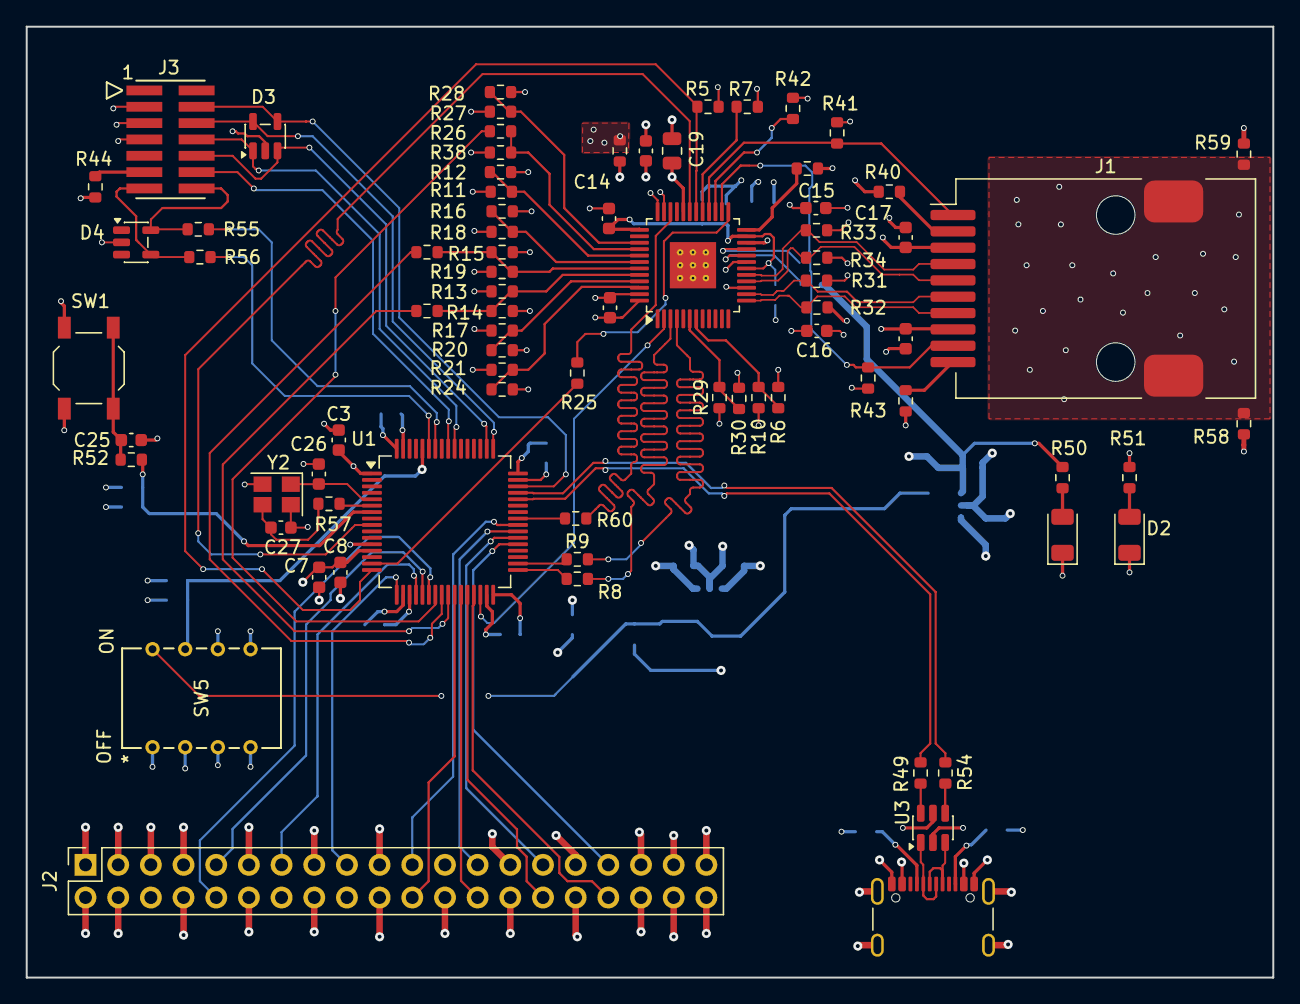
[picture p14: board FatChudRuns.kicad_pcb from above]

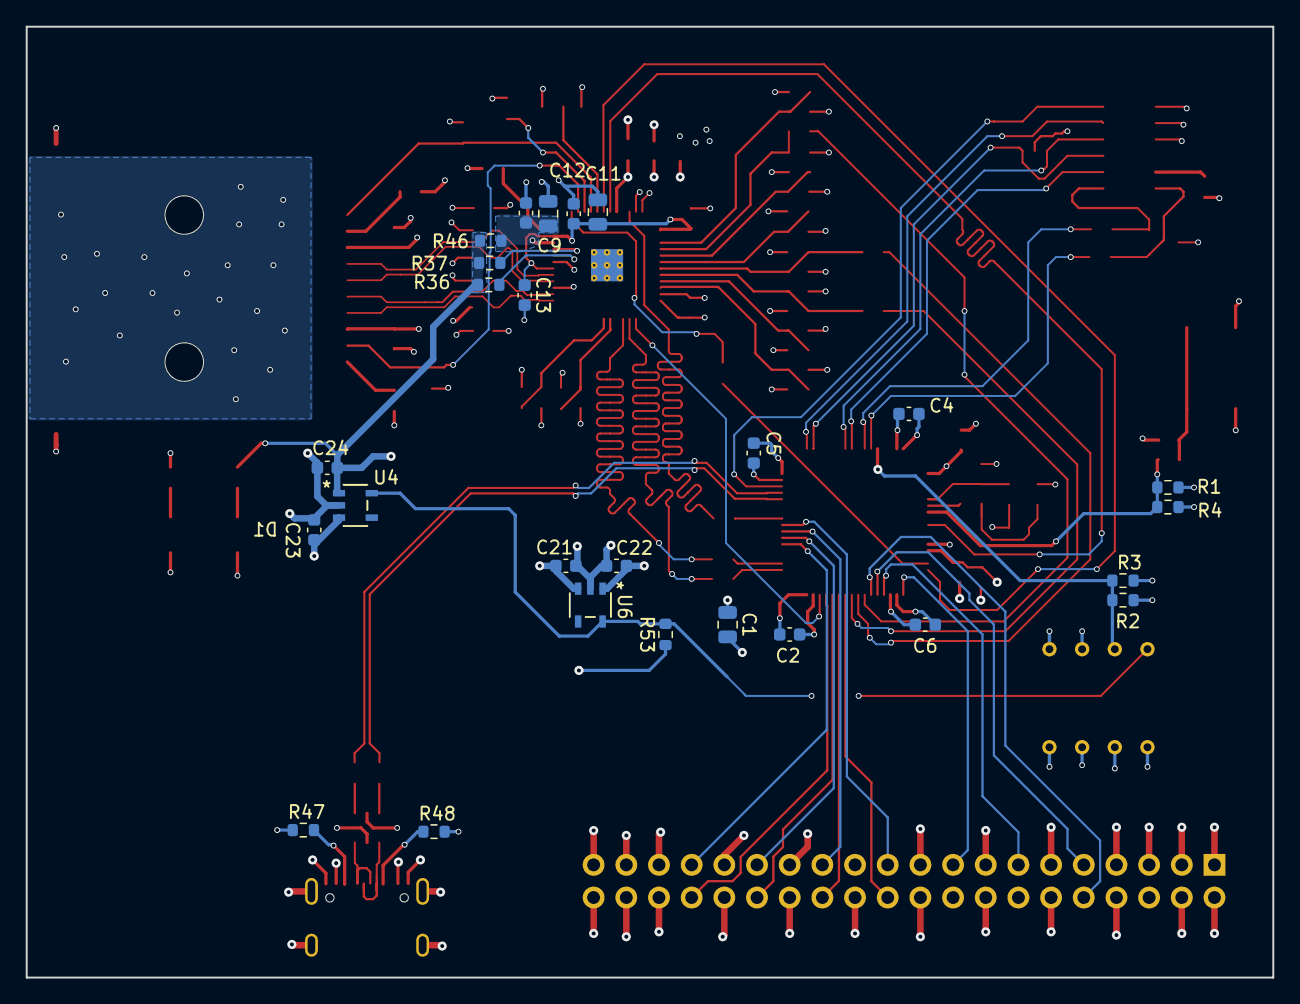
[picture p15: board FatChudRuns.kicad_pcb from below]

Board: 4 copper layers, 96.9 x 73.9 mm, 104 parts (26 on the bottom side), 84 nets.
