AerorKus/FatChudRuns/(commit log)

2026-02-07 updated stm32 firmware for pin selection, added pcb guidelines pdf
2026-02-10 added switch and dip switch for mcu, decoup caps. new sheets for power and eth phy
    [ETH_PHY.kicad_sch, FatChudRuns.kicad_sch, MCU.kicad_sch, POWER.kicad_sch]
2026-02-11 connected phy to uC and added strapping options
    [ETH_PHY.kicad_sch, MCU.kicad_sch, POWER.kicad_sch]
2026-02-12 added filters and decoup caps, updated series term
    [ETH_PHY.kicad_sch]
2026-02-19 selected rj45 w/ mag, fixed filtering for power, added snippets of layout recs
    [ETH_PHY.kicad_sch, FatChudRuns.kicad_pcb, FatChudRuns.kicad_sch, MCU.kicad_sch]
2026-02-23 connected rj45 and leds and led strapping resistors
    [ETH_PHY.kicad_sch, FatChudRuns.kicad_pcb, POWER.kicad_sch]
2026-03-01 added connectors for gpio and jtag, need to verify orientation
    [FatChudRuns.kicad_pcb, MCU.kicad_sch, tst-110-01-l-d.stp]
2026-03-02 added debugger and nucleo ref sch
    [CON14_2X7_DUK_FTSH_SAI.step, FatChudRuns.kicad_pcb, FatChudRuns.kicad_sch, MCU.kicad_sch]
2026-03-03 connected remaining gpio pins to connector, added kicad power pins instead of net names
    [ETH_PHY.kicad_sch, MCU.kicad_sch, POWER.kicad_sch]
2026-03-04 add usb c power circuitry, added led for power indication, increased resistance of ethernet leds light to 220ohms
    [ETH_PHY.kicad_sch, MCU.kicad_sch, POWER.kicad_sch, SOT_30M33R_STM.step]
2026-03-07 sorted out erc errors and warning, connected tvs diodes to jtag
    [ETH_PHY.kicad_sch, MCU.kicad_sch, POWER.kicad_sch]
2026-03-09 added caps and diode footprints, all caps now non-polarized ceramic caps
    [ETH_PHY.kicad_sch, FatChudRuns.csv, FatChudRuns.kicad_pcb, MCU.kicad_sch, POWER.kicad_sch]
2026-03-14 added footprint for switches and button - ready for layout
    [FatChudRuns.kicad_pcb, MCU.kicad_sch, POWER.kicad_sch, c-1825360-3-b-3d.stp]
2026-03-20 setup stackup and constraints
    [FatChudRuns.kicad_pcb, MCU.kicad_sch]
2026-03-22 added 4pF caps and Rext to XTAL, initial placement of PCB, added board outline and gnd plane
    [ETH_PHY.kicad_sch, FatChudRuns.kicad_pcb, MCU.kicad_sch, POWER.kicad_sch]
2026-03-23 routed ETH MDI and magnetics portion with chassis ground. added 0ohm resistors to connect gnd and cgnd
    [ETH_PHY.kicad_sch, FatChudRuns.kicad_pcb]
2026-03-24 added one more decoup cap for eth phy (another power pin), routed decoup caps, routed phy filter resistors
    [ETH_PHY.kicad_sch, FatChudRuns.kicad_pcb]
2026-03-29 routed phy usb and clock
    [ETH_PHY.kicad_sch, FatChudRuns.kicad_pcb, FatChudRuns.kicad_sch, MCU.kicad_sch, POWER.kicad_sch]
2026-03-31 routed jtag, ldo, switch, reset button, and decoupling caps. only need GPIO signals
    [FatChudRuns.kicad_pcb, MCU.kicad_sch]
2026-04-01 finished initial layout, removed some gpio pins and reorganized them
    [FatChudRuns.kicad_pcb, MCU.kicad_sch]
2026-04-01 updated constraints, parsed through most drc
    [FatChudRuns.kicad_pcb]
2026-04-03 cleared the rest of the drc - layout complete
    [FatChudRuns.kicad_pcb]
2026-04-03 created gerbers, need to fix dfm
    [FatChudRuns-B_Cu.gbl, FatChudRuns-B_Mask.gbs, FatChudRuns-B_Paste.gbp, FatChudRuns-B_Silkscreen.gbo, FatChudRuns-Edge_Cuts.gm1, FatChudRuns-F_Cu.gtl, FatChudRuns-F_Mask.gts, FatChudRuns-F_Paste.gtp]
2026-04-10 updated 3d model footprint for Rj45 (created new library)
    [ETH_PHY.kicad_sch, FatChudRuns.csv, FatChudRuns.kicad_pcb, FatChudRuns.kicad_sch, JXD6-0001NL.step]
2026-04-10 updated 10uF to 0805, completed BOM, sent to fab
    [ETH_PHY.kicad_sch, FatChudRuns.kicad_pcb, MCU.kicad_sch, POWER.kicad_sch, bom.csv, designators.csv, positions.csv]
